gluonsandquarks/frida/hardware/assets/3d-view.png

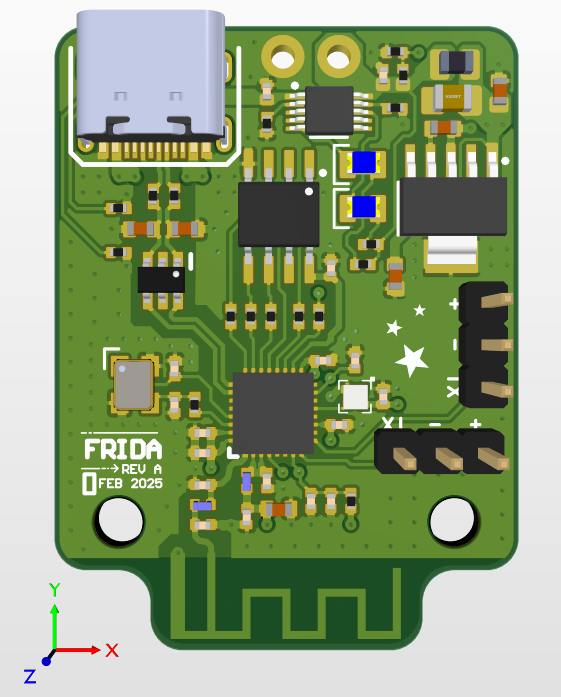
hardware/assets/3d-view.png
