gluonsandquarks/frida/README.md

# FRIDA: Food Release Intelligent Dispensing Automation

In other words, an automatic food dispenser for my cat, Frida :)

> [!NOTE]
> This device/product is still in early development, at the moment focusing on hardware development. Up next will be mechanical design and in parallel firmware.
