gluonsandquarks/frida/hardware/assets/sch.pdf

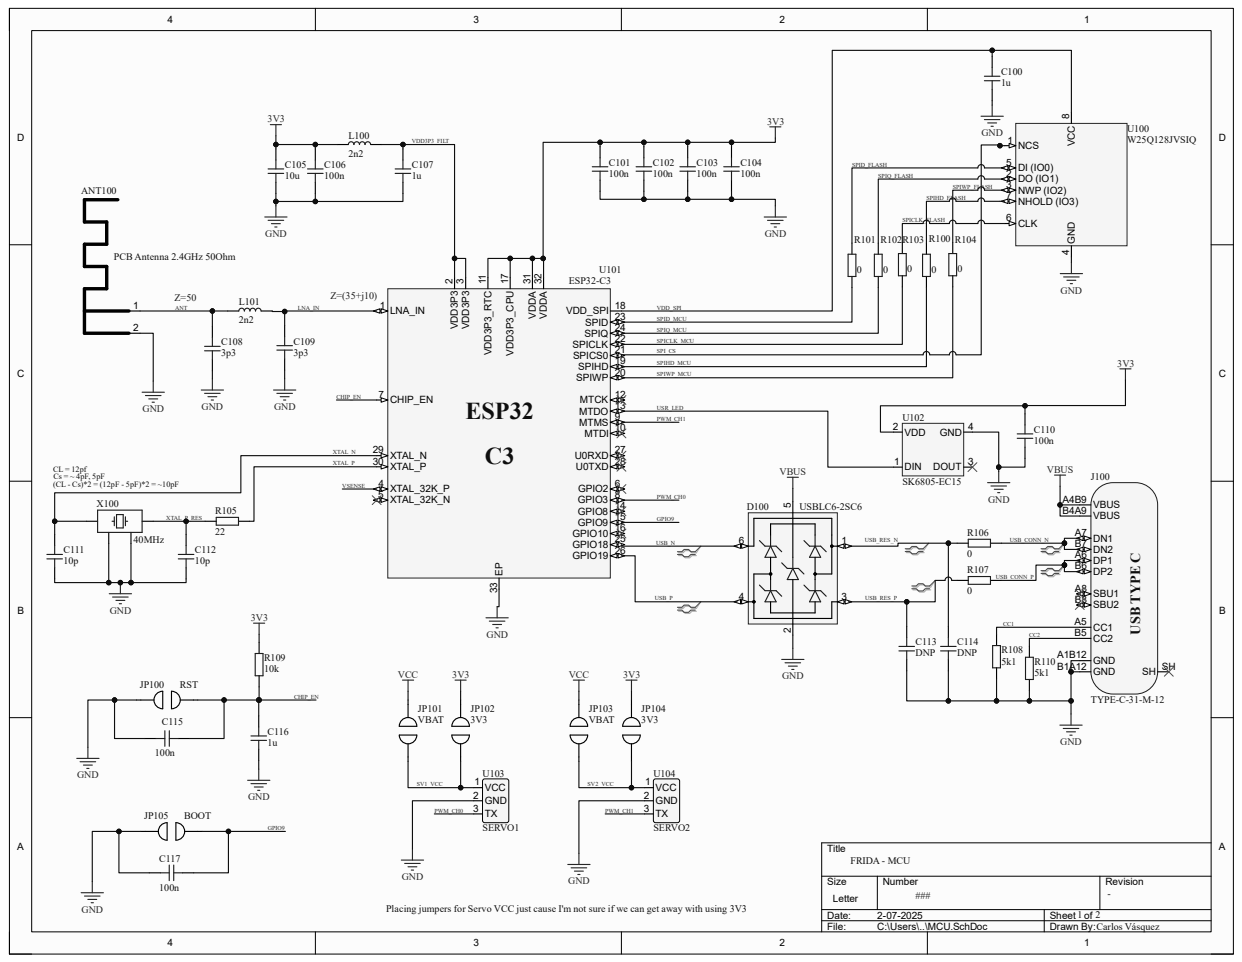
[picture p2: page 1]

Placing jumpers for Servo VCC just cause I'm not sure if we can get away with using 3V3

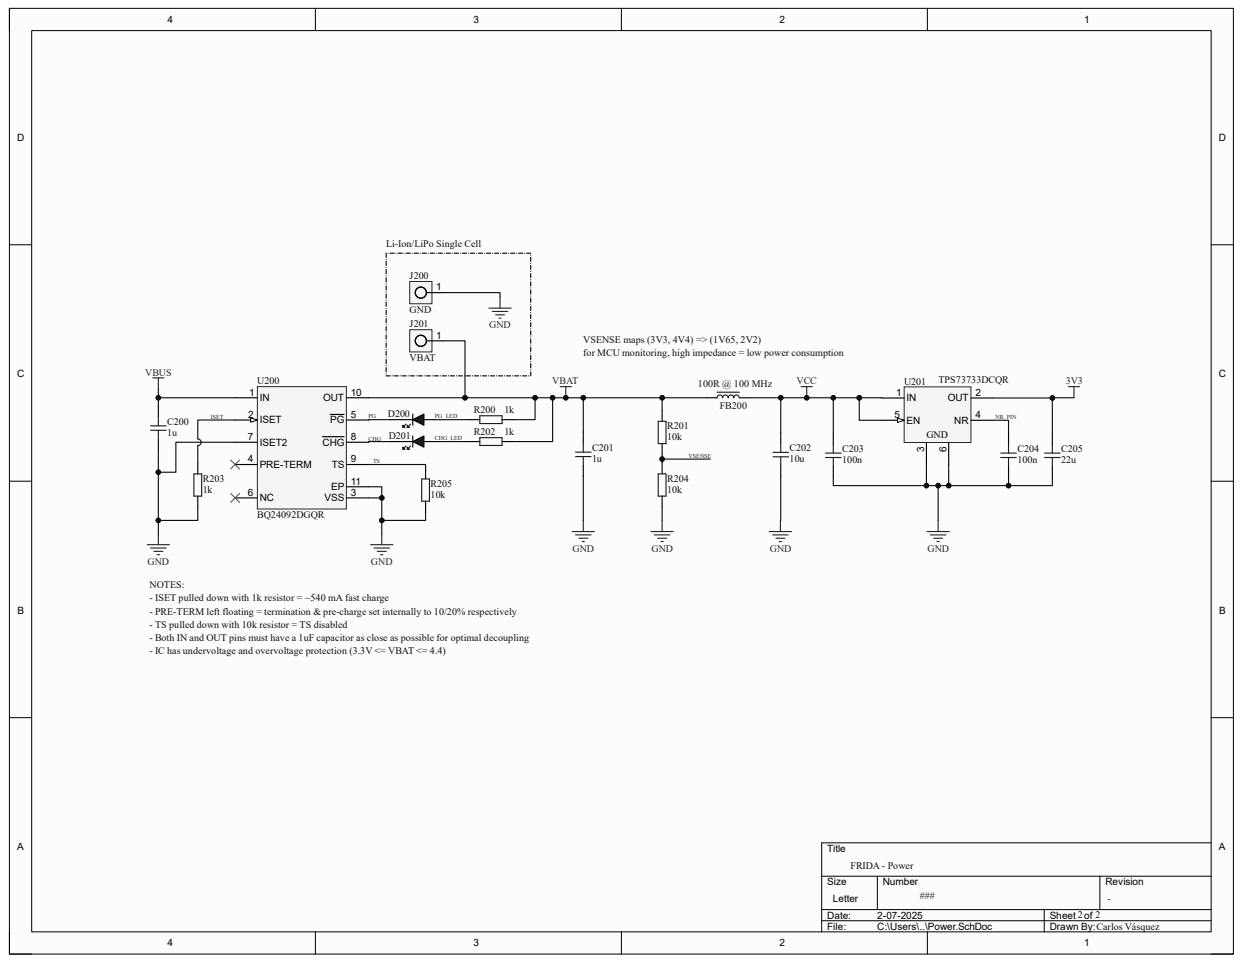
[picture p3: page 2]

Li-Ion/LiPo Single Cell

VSENSE maps (3V3, 4V4) => (1V65, 2V2)
for MCU monitoring, high impedance = low power consumption

NOTES:
- ISET pulled down with 1k resistor = ~540 mA fast charge
- PRE-TERM left floating = termination & pre-charge set internally to 10/20% respectively
- TS pulled down with 10k resistor = TS disabled
- Both IN and OUT pins must have a 1uF capacitor as close as possible for optimal decoupling
- IC has undervoltage and overvoltage protection (3.3V <= VBAT <= 4.4)
