gluonsandquarks/frida/(list of files, drawings)

Other design files:
hardware/Frida.PcbDoc
hardware/frida.PrjPcb
hardware/MCU.SchDoc
hardware/Power.SchDoc
