gluonsandquarks/frida/(commit log)

2025-02-07 Ready. Set. Go!
    [MCU.SchDoc, frida.PrjPcb]
2025-02-07 update readme with current project status
2025-02-07 finished electrical design, no erc violations, added battery charger and peripherals to mcu
    [MCU.SchDoc, Power.SchDoc, frida.PrjPcb]
2025-02-08 rough pcb layout done, in the middle of routing
    [Frida.PcbDoc, frida.PrjPcb]
2025-02-08 finished board routing, silkscreen, design rules check
    [Frida.PcbDoc, MCU.SchDoc, Power.SchDoc]
2025-02-08 finished pcb board, finished outputs for gerbers, componente placement file, bill of materials, ready to order at jlcpcb
    [Frida_Copper_Signal_1.gbr, Frida_Copper_Signal_2.gbr, Frida_Copper_Signal_Bot.gbr, Frida_Copper_Signal_Top.gbr, Frida_Legend_Bot.gbr, Frida_Legend_Top.gbr, Frida_NPTH_Drill.gbr, Frida_PTH_Drill.gbr]
2025-02-24 fixed silkscreen rgb led for assembly
    [Frida_Copper_Signal_1.gbr, Frida_Copper_Signal_2.gbr, Frida_Copper_Signal_Bot.gbr, Frida_Copper_Signal_Top.gbr, Frida_Legend_Bot.gbr, Frida_Legend_Top.gbr, Frida_NPTH_Drill.gbr, Frida_PTH_Drill.gbr]
